gnxlxnxx/christmas_card_24/star/PCB-USB-C/README.md

KiCAD conversion of the USB-C connector from Pinuct's [Eagle PCB USB connectors](https://github.com/Pinuct/Eagle_PCB_USB_connectors).
