gnxlxnxx/christmas_card_24/star/star.kicad_pcb

## KiCad design star/star.kicad_pcb (2024-12-19)

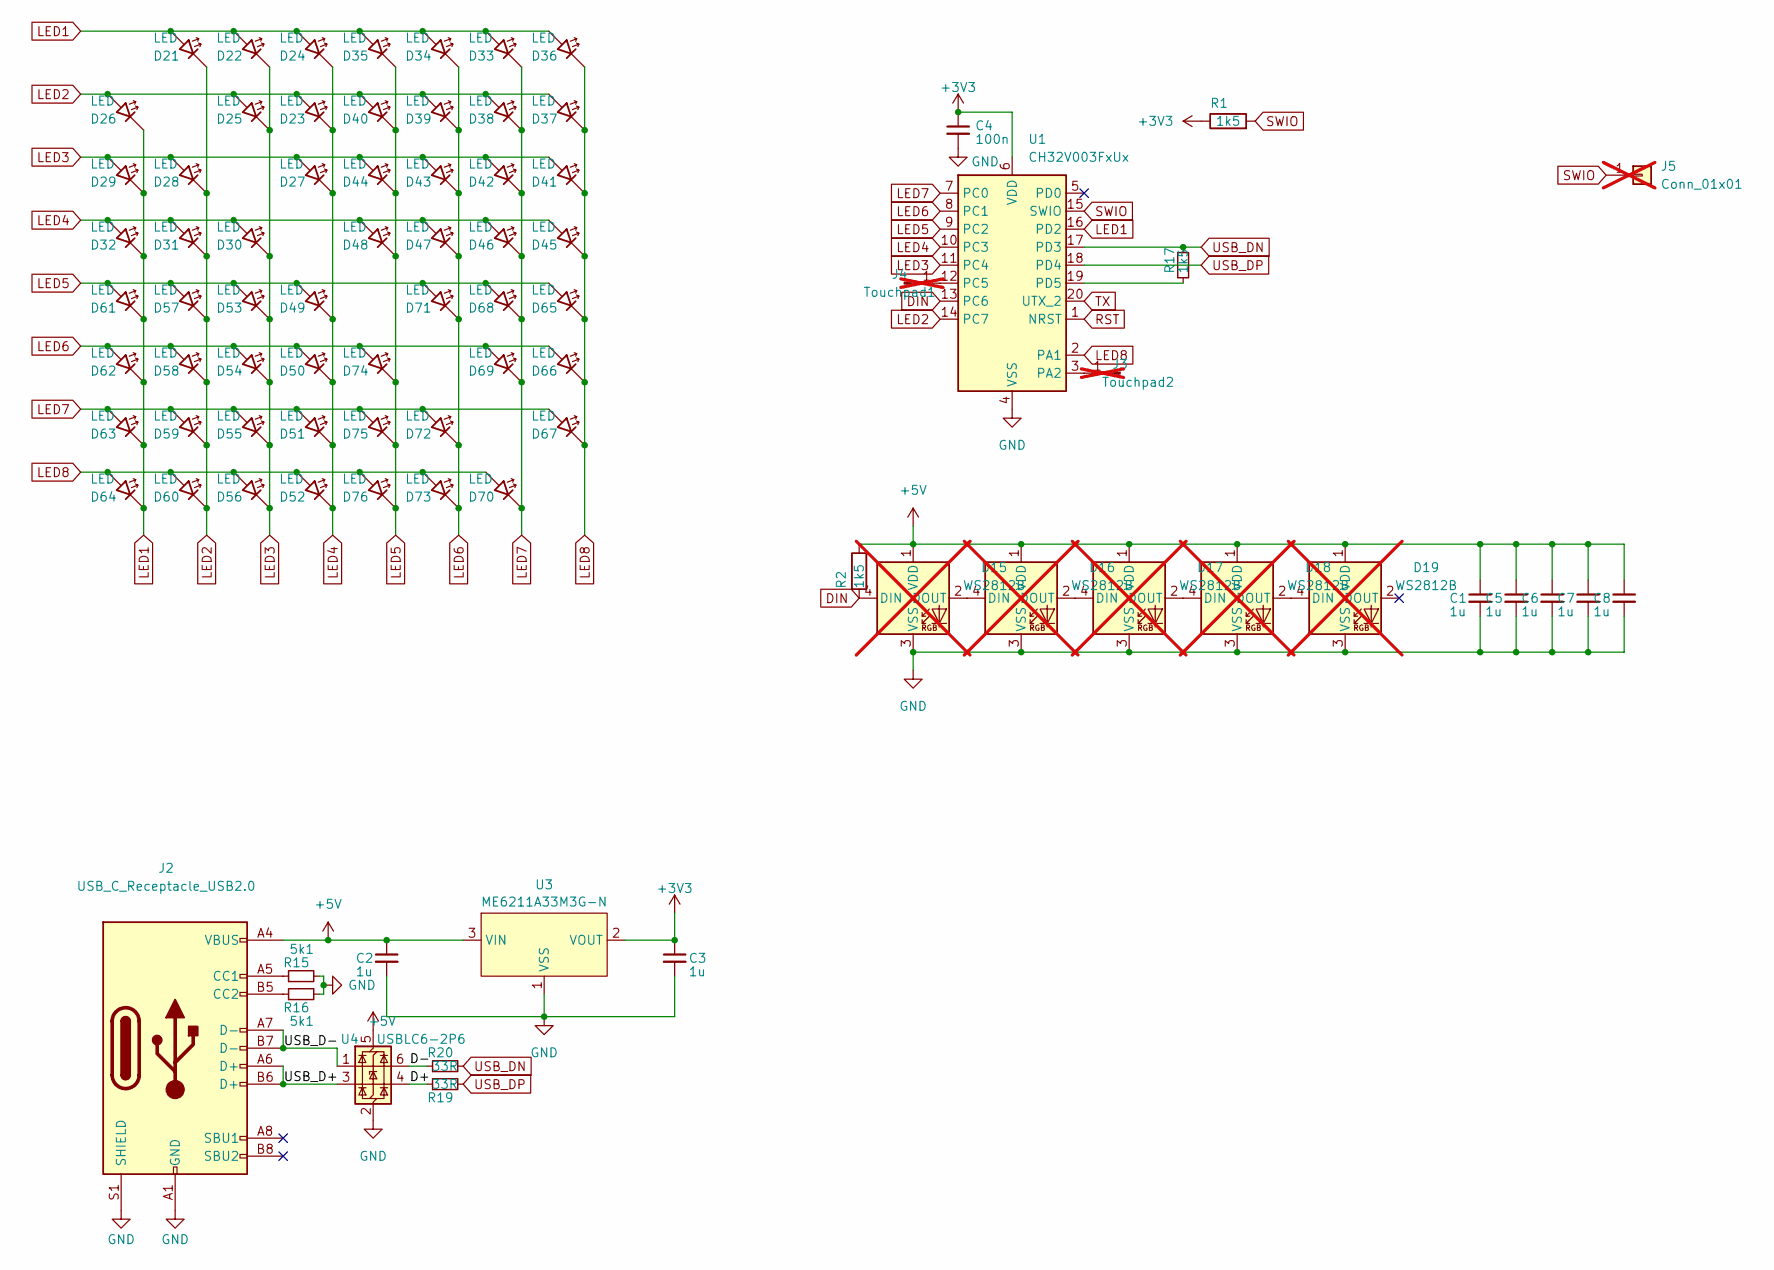
[picture p1: schematic star.kicad_sch]

Parts:
C1, C2, C3, C5, C6, C7, C8: 1u; C_0402_1005Metric; LCSC C52923
C4: 100n; C_0402_1005Metric; LCSC C1525
D15, D16, D17, D18, D19: WS2812B; LED_WS2812B_PLCC4_5.0x5.0mm_P3.2mm; LCSC C965555; not fitted
D21, D22, D23, D24, D25, D26, D27, D28, D29, D30, D31, D32, D33, D34, D35, D36, D37, D38, D39, D40, D41, D42, D43, D44, D45, D46, D47, D48, D49, D50, D51, D52, D53, D54, D55, D56, D57, D58, D59, D60, D61, D62, D63, D64, D65, D66, D67, D68, D69, D70, D71, D72, D73, D74, D75, D76: LED; LED_0603_1608Metric_Pad1.05x0.95mm_HandSolder; LCSC C497938
J2: USB_C_Receptacle_USB2.0; TYPE C 16 PIN MIDDLE MOUNT CH 0.52; LCSC C2927036
J3: Touchpad2; touch_pad; not fitted
J4: Touchpad1; touch_pad; not fitted
J5: Conn_01x01; pogo_pin_conn_01x01; not fitted
R1, R2, R17: 1k5; R_0402_1005Metric; LCSC C25867
R15, R16: 5k1; R_0402_1005Metric; LCSC C25905
R19, R20: 33R; R_0402_1005Metric; LCSC C25105
U1: CH32V003FxUx; QFN-20-1EP_3x3mm_P0.4mm_EP1.65x1.65mm; LCSC C5299908
U3: ME6211A33M3G-N; SOT-23-3; LCSC C168807
U4: USBLC6-2P6; SOT-666; LCSC C2827693

Connections:
+3V3: C3.1, C4.1, R1.1, U1.6 (VDD), U3.2 (VOUT)
+5V: C1.1, C2.1, C5.1, C6.1, C7.1, C8.1, D15.1 (VDD), D16.1 (VDD), D17.1 (VDD), D18.1 (VDD), D19.1 (VDD), J2.A4 (VBUS), J2.A9 (VBUS), J2.B4 (VBUS), J2.B9 (VBUS), R2.1, U3.3 (VIN), U4.5 (VBUS)
/D+: R19.1, U4.4 (I/O2)
/D-: R20.1, U4.6 (I/O1)
/USB_D+: J2.A6 (D+), J2.B6 (D+), U4.3 (I/O2)
/USB_D-: J2.A7 (D-), J2.B7 (D-), U4.1 (I/O1)
DIN: D15.4 (DIN), R2.2, U1.13 (PC6)
GND: C1.2, C2.2, C3.2, C4.2, C5.2, C6.2, C7.2, C8.2, D15.3 (VSS), D16.3 (VSS), D17.3 (VSS), D18.3 (VSS), D19.3 (VSS), J2.A1 (GND), J2.A12 (GND), J2.B1 (GND), J2.B12 (GND), J2.S1 (SHIELD), R15.2, R16.2, U1.4 (VSS), U1.21 (VSS), U3.1 (VSS), U4.2 (GND)
LED1: D21.2 (A), D22.2 (A), D24.2 (A), D26.1 (K), D29.1 (K), D32.1 (K), D33.2 (A), D34.2 (A), D35.2 (A), D36.2 (A), D61.1 (K), D62.1 (K), D63.1 (K), D64.1 (K), U1.16 (PD2)
LED2: D21.1 (K), D23.2 (A), D25.2 (A), D26.2 (A), D28.1 (K), D31.1 (K), D37.2 (A), D38.2 (A), D39.2 (A), D40.2 (A), D57.1 (K), D58.1 (K), D59.1 (K), D60.1 (K), U1.14 (PC7)
LED3: D22.1 (K), D25.1 (K), D27.2 (A), D28.2 (A), D29.2 (A), D30.1 (K), D41.2 (A), D42.2 (A), D43.2 (A), D44.2 (A), D53.1 (K), D54.1 (K), D55.1 (K), D56.1 (K), U1.11 (PC4)
LED4: D23.1 (K), D24.1 (K), D27.1 (K), D30.2 (A), D31.2 (A), D32.2 (A), D45.2 (A), D46.2 (A), D47.2 (A), D48.2 (A), D49.1 (K), D50.1 (K), D51.1 (K), D52.1 (K), U1.10 (PC3)
LED5: D35.1 (K), D40.1 (K), D44.1 (K), D48.1 (K), D49.2 (A), D53.2 (A), D57.2 (A), D61.2 (A), D65.2 (A), D68.2 (A), D71.2 (A), D74.1 (K), D75.1 (K), D76.1 (K), U1.9 (PC2)
LED6: D34.1 (K), D39.1 (K), D43.1 (K), D47.1 (K), D50.2 (A), D54.2 (A), D58.2 (A), D62.2 (A), D66.2 (A), D69.2 (A), D71.1 (K), D72.1 (K), D73.1 (K), D74.2 (A), U1.8 (PC1)
LED7: D33.1 (K), D38.1 (K), D42.1 (K), D46.1 (K), D51.2 (A), D55.2 (A), D59.2 (A), D63.2 (A), D67.2 (A), D68.1 (K), D69.1 (K), D70.1 (K), D72.2 (A), D75.2 (A), U1.7 (PC0)
LED8: D36.1 (K), D37.1 (K), D41.1 (K), D45.1 (K), D52.2 (A), D56.2 (A), D60.2 (A), D64.2 (A), D65.1 (K), D66.1 (K), D67.1 (K), D70.2 (A), D73.2 (A), D76.2 (A), U1.2 (PA1)
unnamed: D15.2 (DOUT), D16.4 (DIN)
unnamed: D16.2 (DOUT), D17.4 (DIN)
unnamed: D17.2 (DOUT), D18.4 (DIN)
unnamed: D18.2 (DOUT), D19.4 (DIN)
unnamed: J2.A5 (CC1), R15.1
unnamed: J2.B5 (CC2), R16.1
unnamed: J3.1, U1.3 (PA2)
unnamed: J4.1, U1.12 (PC5)
unnamed: R17.2, U1.19 (PD5)
RST: U1.1 (NRST)
SWIO: J5.1, R1.2, U1.15 (SWIO)
TX: U1.20 (UTX_2)
USB_DN: R17.1, R20.2, U1.17 (PD3)
USB_DP: R19.2, U1.18 (PD4)

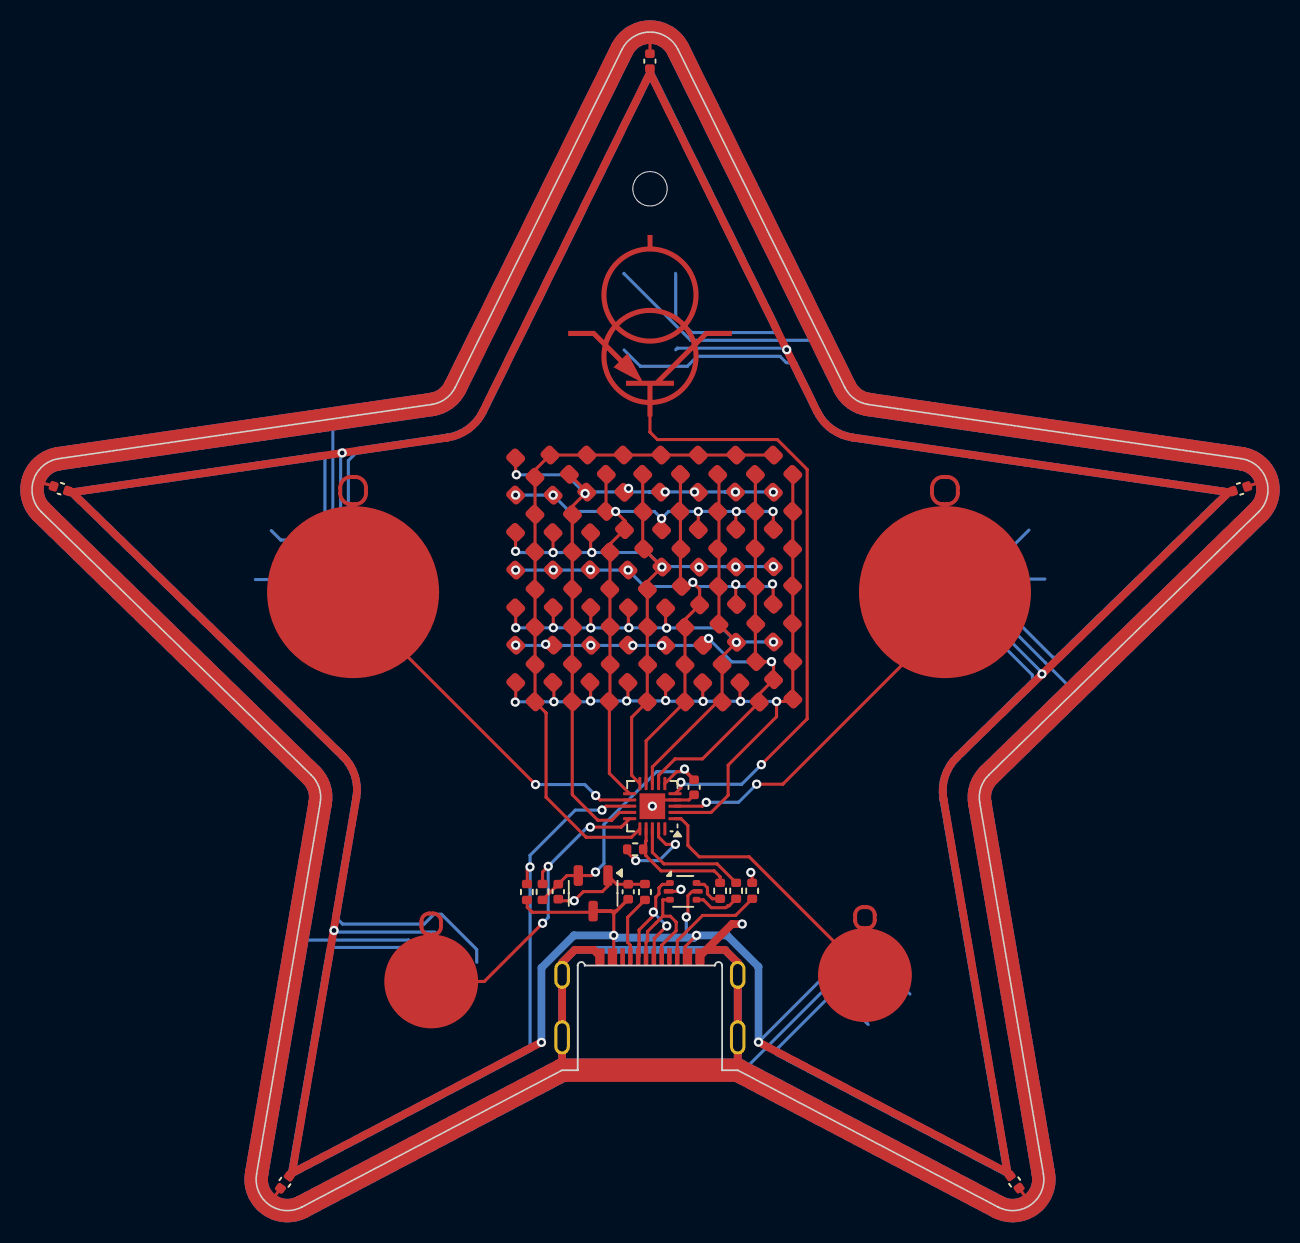
[picture p2: board star.kicad_pcb from above]

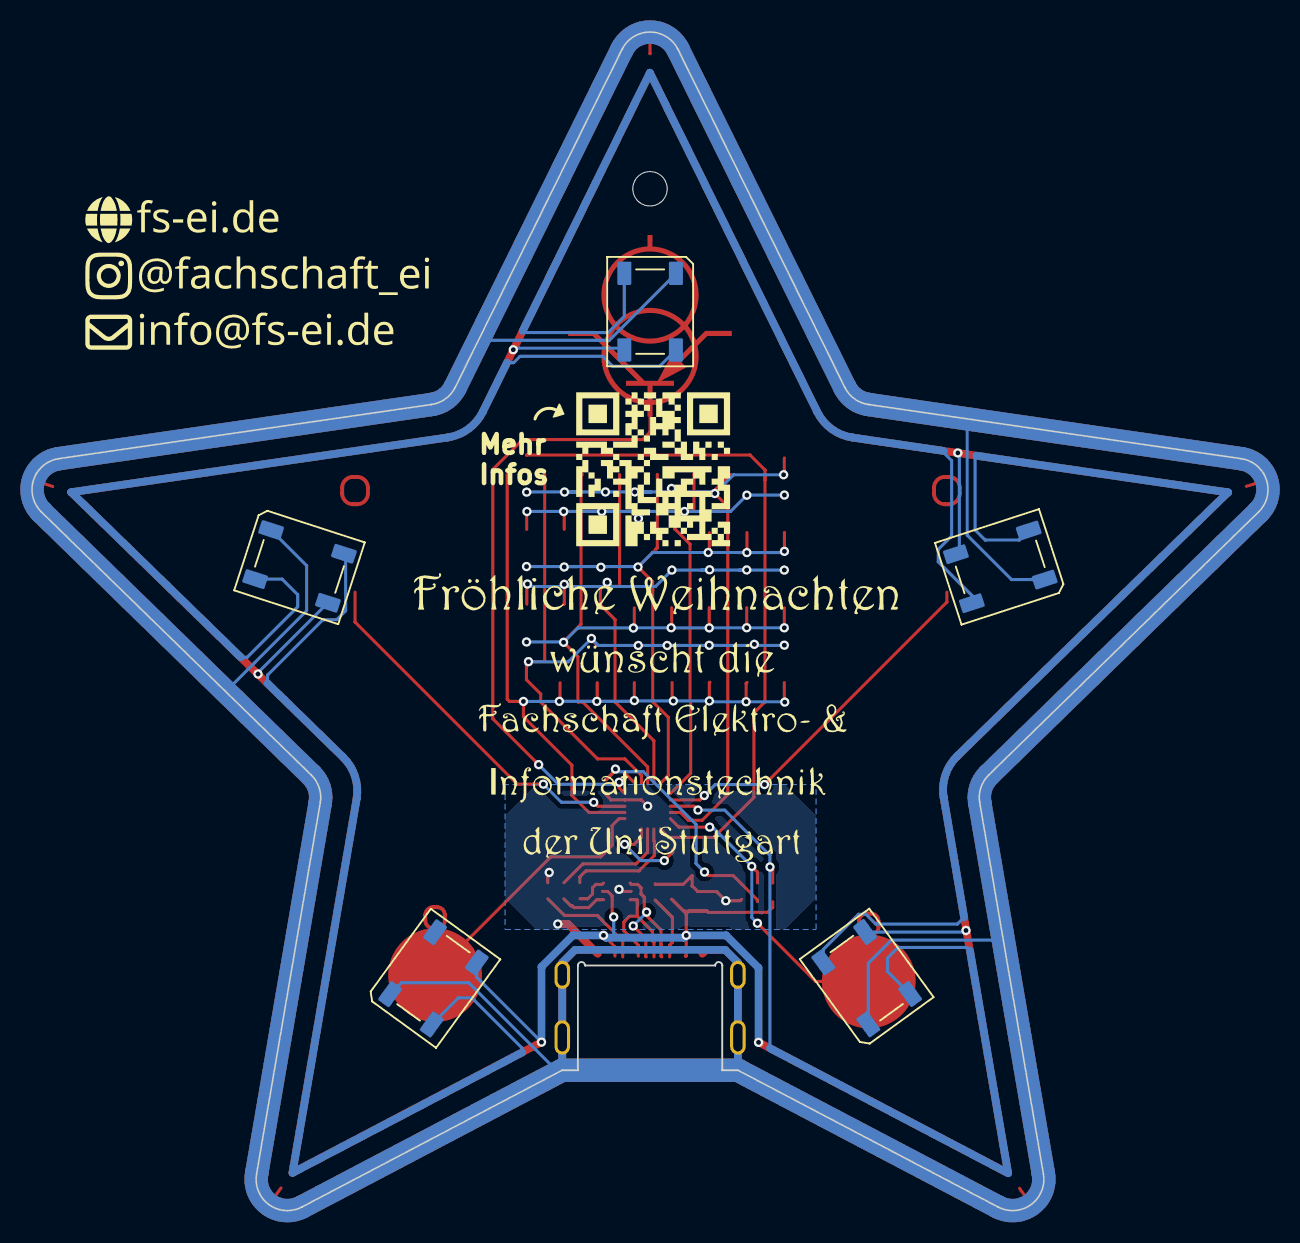
[picture p3: board star.kicad_pcb from below]

Board: 2 copper layers, 79.1 x 75.4 mm, 82 parts (5 on the bottom side), 28 nets.
