gnxlxnxx/christmas_card_24/main.c

#include <ch32fun.h>
#include <stdbool.h>
#include "main.h"
#include "matrix/matrix.h"
#include "matrix/animations.h"
#include "games/snake.h"
#include "usb.h"
#include "ws2812.h"
#include "touch.h"

static enum main_modes {
  MODE_ANIMATIONS,
  MODE_SNAKE,
  MODE_END,
} mode;

static bool lock_animations = false;

int main(void) {
  SystemInit();
  RCC->APB2PCENR |= RCC_APB2Periph_GPIOD | RCC_APB2Periph_GPIOC |
                    RCC_APB2Periph_GPIOA | RCC_APB2Periph_AFIO |
                    RCC_APB2Periph_TIM1;
  RCC->APB1PCENR |= RCC_APB1Periph_TIM2;

  ws2812_init();
  usb_init();
  matrix_init();

  touch_init();
  if (btn_left && btn_right) {
    lock_animations = true;
  } else if (btn_left) {
    open_url_windows();
  } else if (btn_right) {
    open_url();
  }

  while (true) {
    uint32_t start = SysTick->CNT;

    matrix_update();
    ws2812_update();
    switch (mode) {
      case MODE_ANIMATIONS:
        matrix_animation_update();

        touch_update();
        if (!lock_animations) {
          if (btn_left && btn_right && (btn_left_toggled || btn_right_toggled)) {
            mode = MODE_SNAKE;
            snake_start();
          } else if (btn_left && btn_left_toggled) {
            ws2812_next_mode();
          } else if (btn_right && btn_right_toggled) {
            matrix_next_mode();
          }
        }
        break;
      case MODE_SNAKE:
        touch_update();
        if (!snake_step()) {
          mode = MODE_ANIMATIONS;
          matrix_next_mode();
        }
        break;
      default:;
    }

    while (SysTick->CNT - start < Ticks_from_Us(256)) {}
  }
}
