gnxlxnxx/christmas_card_24/ws2812.c

#include <ch32fun.h>
#include <stdint.h>
#include "touch.h"
#include "random.h"
#include "touch.h"

#define WS2812DMA_IMPLEMENTATION
#define WSGRB // For SK6805-EC15
#define NR_LEDS 6

static uint16_t phases[NR_LEDS];
static int frameno = 0;
volatile static int tween = -NR_LEDS;

#include "ws2812b_dma_spi_led_driver.h"
#include "color_utilities.h"

static enum ws2812_modes {
  MODE_FIRE,
  MODE_SNOWBALL,
  MODE_HUEWHEEL,
  MODE_END
} mode;

static int ws2812_counter = 0;
static uint32_t snow_balls[NR_LEDS] = {0}; // TODO: Hardcoded LED count
static uint32_t desired_output[NR_LEDS] = {0};
static uint32_t output[NR_LEDS] = {0};

static volatile int b1counter = 0;
static volatile int b2counter = 0;

static const uint16_t led_angles[] = {
    0, 60, 120, 180, 240, 300};

uint32_t WS2812BLEDCallback(int ledno) {

  // switch between modes on the back side
  switch (mode) {
  case MODE_FIRE:
    // Original "Fire" mode
    uint8_t index = (phases[ledno]) >> 8;
    uint8_t rsbase = sintable[index];
    uint8_t rs = rsbase >> 3;
    desired_output[ledno] = ((huetable[(rs + 190) & 0xff] >> 3) << 16) |
                            (huetable[(rs + 30) & 0xff] >> 2) |
                            ((huetable[(rs + 0)] >> 3) << 8);
    break;
  case MODE_SNOWBALL:
    // "Snowball" mode
    if (ws2812_counter++ < 300) {
      desired_output[ledno] = snow_balls[ledno];
    } else {
      int num_snowballs_l = 0;
      for (int i = 3; i < 6; i++)
        num_snowballs_l += (snow_balls[i] != 0);
      int num_snowballs_r = 0;
      for (int i = 0; i < 3; i++)
        num_snowballs_r += (snow_balls[i] != 0);
      uint8_t hue = rand8();
      snow_balls[0] = snow_balls[1];
      snow_balls[1] = snow_balls[2];
      snow_balls[2] = rand8() % (3 + num_snowballs_r)
                          ? 0
                          : (huetable[(hue + 170) & 0xff] << 16) |
                                huetable[(hue + 85) & 0xff] |
                                (huetable[(hue + 0)] << 8);

      hue = rand8();
      snow_balls[5] = snow_balls[4];
      snow_balls[4] = snow_balls[3];
      snow_balls[3] = rand8() % (3 + num_snowballs_l)
                          ? 0
                          : (huetable[(hue + 170) & 0xff] << 16) |
                                huetable[(hue + 85) & 0xff] |
                                (huetable[(hue + 0)] << 8);

      ws2812_counter = 0;
    }
    break;
  case MODE_HUEWHEEL:
    // "Huewheel" mode
    uint8_t ang = (ws2812_counter >> 3) + led_angles[ledno];
    desired_output[ledno] = huetable[(ang + 170) & 0xff] << 16 |
                            huetable[(ang + 85) & 0xff] |
                            huetable[ang & 0xff] << 8;
    if (ledno == NR_LEDS - 1) {
      ws2812_counter = (ws2812_counter + 1) & 0x7ff;
    }
    break;
  default:;
  }

  for (int i = 0; i < 3; i++) {
    if (((output[ledno] >> (i << 3)) & 0xFF) >
        ((desired_output[ledno] >> (i << 3)) & 0xFF)) {
      output[ledno] -= 1 << (i << 3);
    } else if (((output[ledno] >> (i << 3)) & 0xFF) <
               ((desired_output[ledno] >> (i << 3)) & 0xFF)) {
      output[ledno] += 1 << (i << 3);
    }
  }

  uint32_t value = output[ledno];
  if (b1counter) {
    switch (ledno) {
    case 5:
    case 3:
      value |= (b1counter >> 3) << 16;
      break;
    case 4:
      value |= b1counter << 16;
      break;
    }
  }

  if (b2counter) {
    switch (ledno) {
    case 0:
    case 2:
      value |= (b2counter >> 3) << 16;
      break;
    case 1:
      value |= b2counter << 16;
      break;
    }
  }

  return value;
}

void ws2812_init(void) {
  WS2812BDMAInit();

  for (int k = 0; k < NR_LEDS; k++)
    phases[k] = k << 8;
}

void ws2812_update(void) {
  static int tweendir = 0;
  static int ws2812counter = 0;

  if (ws2812counter == 48) {
    if (!WS2812BLEDInUse) {
      if (btn_right) {
        b1counter = 128;
      }
      if (btn_left) {
        b2counter = 128;
      }
      if (b1counter) {
        b1counter -= 4;
      }
      if (b2counter) {
        b2counter -= 4;
      }
      ws2812counter = 0;
      frameno++;

      if (frameno == 1024) {
        tweendir = 1;
      }
      if (frameno == 2048) {
        tweendir = -1;
        frameno = 0;
      }

      if (tweendir) {
        int t = tween + tweendir;
        if (t > 255)
          t = 255;
        if (t < -NR_LEDS)
          t = -NR_LEDS;
        tween = t;
      }

      for (int k = 0; k < NR_LEDS; k++) {
        phases[k] += ((((rands[k & 0xff]) + 0xf) << 2) +
            (((rands[k & 0xff]) + 0xf) << 1)) >>
          1;
      }

      WS2812BDMAStart(NR_LEDS);
    }
  } else {
    ws2812counter++;
  }
}

void ws2812_next_mode(void) {
  mode = (mode + 1) % MODE_END;
}
