gnxlxnxx/christmas_card_24/matrix/letters.h

#ifndef MATRIX_LETTERS_H_
#define MATRIX_LETTERS_H_

// TODO: 9 height font idea:
// 00-7f: fill col from row 0 (top)
// 80:    mark end of character
// 81-ff: fill col from row 2

#include <stdint.h>

#define MAX_COLS 5

static const int8_t ascii_printable[][MAX_COLS] = {
  // SPACE
  {
    0b0000000,
    -1
  },
  // EXCL
  {
    0b1011111,
    -1
  },
  // "
  {
    0b0000011,
    0b0000000,
    0b0000011,
    -1
  },
  // #
  {
    0b0010100,
    0b1111111,
    0b0010100,
    0b1111111,
    0b0010100,
  },
  // $
  {
    0b0100110,
    0b1001001,
    0b1111111,
    0b1001001,
    0b0110010,
  },
  // %
  {
    0b0100010,
    0b0010000,
    0b0001000,
    0b0000100,
    0b0100010,
  },
  // &
  {
    0b0110110,
    0b1001001,
    0b1010001,
    0b0100010,
    0b1010000,
  },
  // '
  {
    0b0000011,
    -1
  },
  // (
  {
    0b0111110,
    0b1000001,
    -1
  },
  // )
  {
    0b1000001,
    0b0111110,
    -1
  },
  // *
  {
    0b0101010,
    0b0011100,
    0b1111111,
    0b0011100,
    0b0101010,
  },
  // +
  {
    0b0001000,
    0b0001000,
    0b0111110,
    0b0001000,
    0b0001000,
  },
  // ,
  {
    0b1100000,
    -1
  },
  // -
  {
    0b0001000,
    0b0001000,
    0b0001000,
    -1
  },
  // .
  {
    0b1000000,
    -1
  },
  // /
  {
    0b1100000,
    0b0011100,
    0b0000011,
    -1
  },
  // 0
  {
    0b0111110,
    0b1010001,
    0b1001001,
    0b1000101,
    0b0111110,
  },
  // 1
  {
    0b0000010,
    0b1111111,
    -1
  },
  // 2
  {
    0b1000010,
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
      return letter_ae;
    case 'ß':
      return letter_sz;
    case '\x80':
      return letter_uni_stuttgart;
    default:
      return letter_unknown;
  }
}

static int8_t get_col(char c, int col) {
  if (col >= MAX_COLS) {
    return -1;
  }

  return get_letter(c)[col];
}


#endif
