gnxlxnxx/christmas_card_24/(commit log)

2023-12-14 initial (mostly working) state
    only the touch pads are completely missing
    [main.c]
2023-12-15 add basic timer stuff (TIM1 doesn't seem to work)
    [main.c, matrix.c, matrix.h]
2023-12-15 fix touch pad & cleanup
    [main.c]
2023-12-15 swtich button order
2023-12-15 add animation on button press (hacky)
2023-12-15 improve multiplex output
    works now after fixing rv003usb
    [main.c, matrix.c]
2023-12-16 Mode switching and random (inverted) pulse mode
    [main.c]
2023-12-17 decrease brightness of adjecent leds for button effect
2023-12-17 Delay col change so leds are all off
2023-12-17 Map both buttons onto one axis
2023-12-17 Improve scale when both buttons pressed
2023-12-18 Fix usb not working under windows
    [usb.c]
2023-12-18 Allow usage of www button
2024-12-17 Make buttons work
2024-12-17 Use buttons
2024-12-17 Adapt ws2812 to new LED arrangement
2024-12-18 Start attempting pwm implementation
2024-12-18 Broken pwm
2024-12-19 add PCB files
    [BOM-star.csv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]
2025-08-26 Fix some smaller issues from after final version
    [matrix.c, touch.c]
2025-11-18 Add swio pin check
