gnxlxnxx/christmas_card_24/(notices)

Notices in the files:
star/PCB-USB-C/README.md:
License: CC BY 4.0
